tommysl8/PixelClock/case/images/foot_inside.png

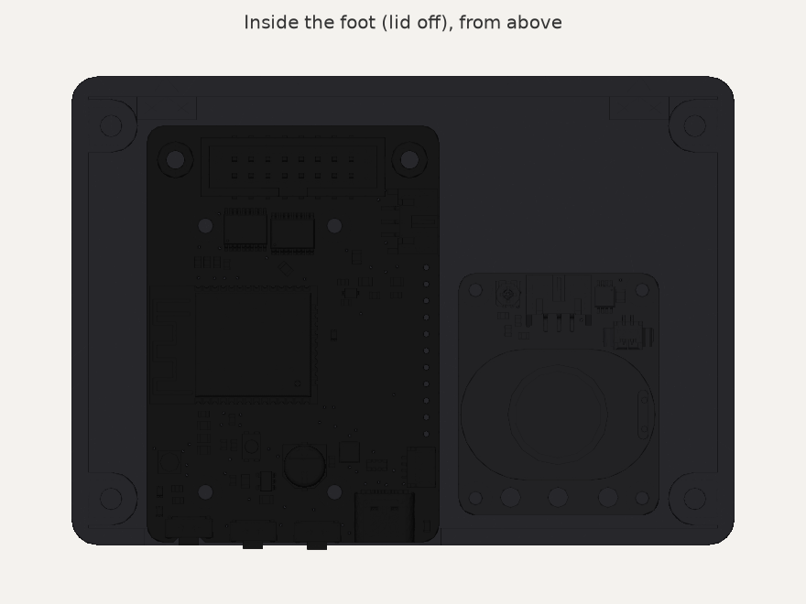
case/images/foot_inside.png
