tommysl8/PixelClock/case/images/side.png

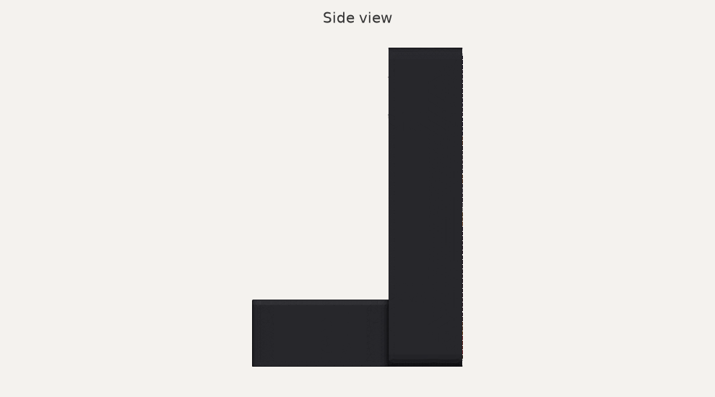
case/images/side.png
