tommysl8/PixelClock/case/step/pixelclock_case_assembly.step

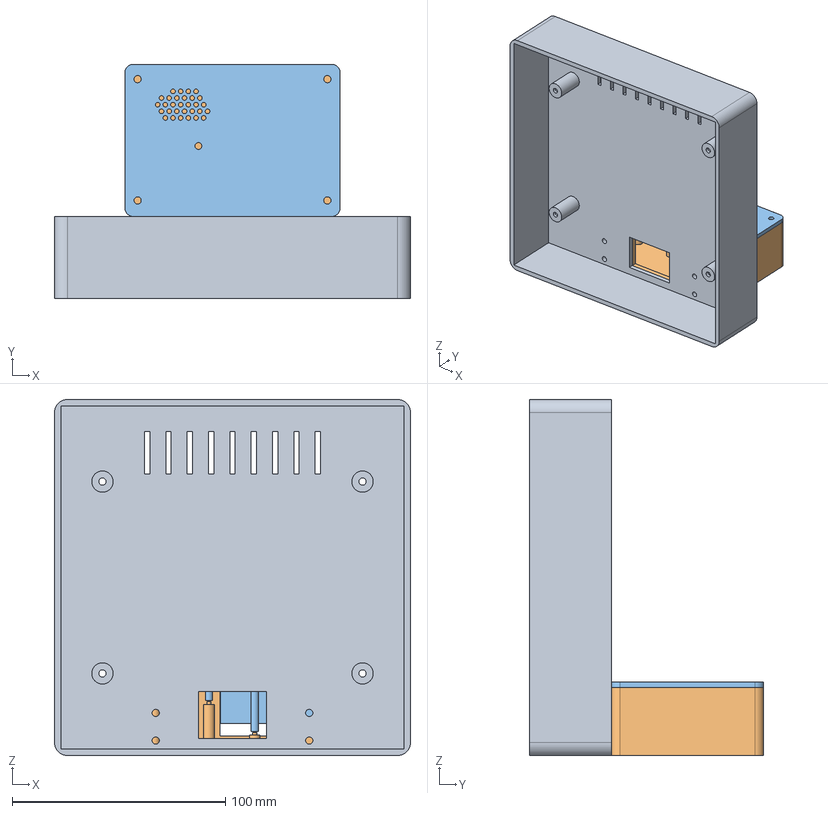
[picture p6: CAD file, 2026-11-12]
case/step/pixelclock_case_assembly.step
167.0 x 110.0 x 167.0 mm
