tommysl8/PixelClock/case/step/pixelclock_lid.step

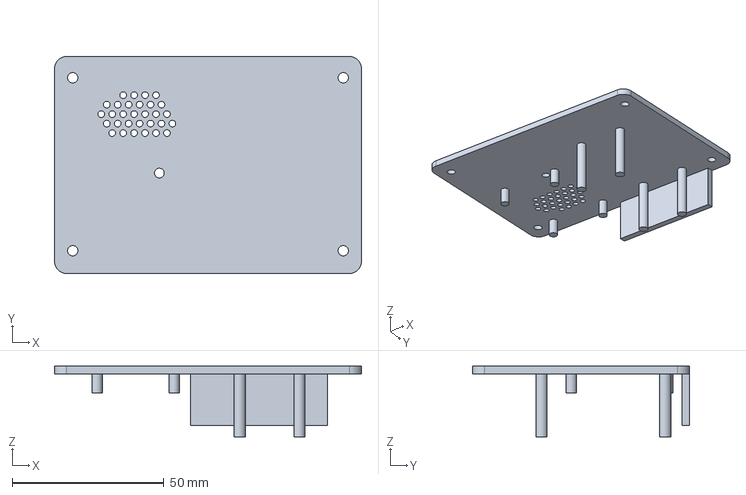
[picture p7: CAD file, 2026-11-12]
case/step/pixelclock_lid.step
101.0 x 71.4 x 23.2 mm
