tommysl8/PixelClock/case/step/pixelclock_display_no_acrylic.step

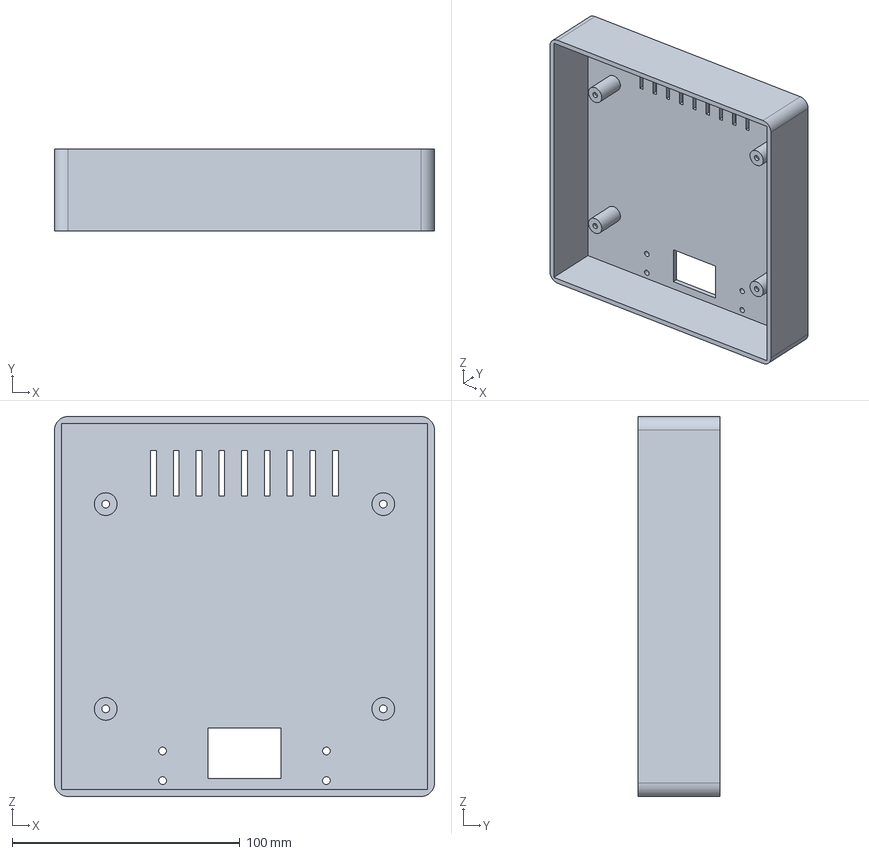
[picture p8: CAD file, 2026-11-12]
case/step/pixelclock_display_no_acrylic.step
167.0 x 36.0 x 167.0 mm
