tommysl8/PixelClock/case/step/pixelclock_display.step

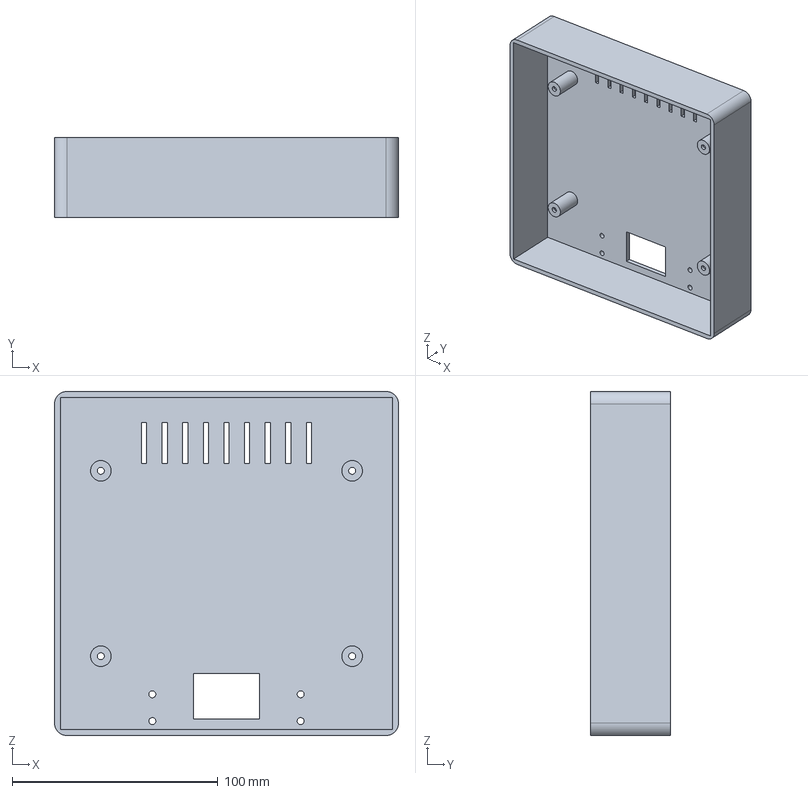
[picture p9: CAD file, 2026-11-12]
case/step/pixelclock_display.step
167.0 x 38.6 x 167.0 mm
