tommysl8/PixelClock/case/step/pixelclock_foot.step

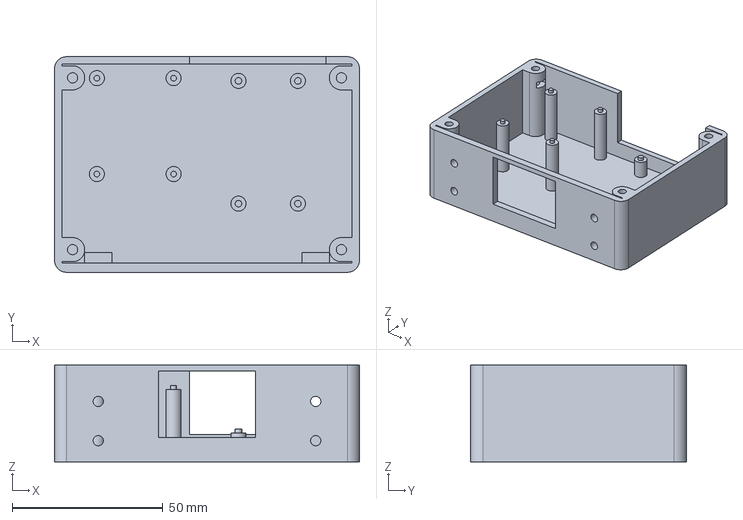
[picture p10: CAD file, 2026-11-12]
case/step/pixelclock_foot.step
101.0 x 71.4 x 32.0 mm
