tommysl8/PixelClock/(list of files, cad)

Other CAD files:
case/stl/pixelclock_display.stl
case/stl/pixelclock_display_no_acrylic.stl
case/stl/pixelclock_foot.stl
case/stl/pixelclock_lid.stl
