tommysl8/PixelClock/(commit log)

2026-11-11 Add browser simulator and winter cabin theme
    A 64x64 LED simulator for the PixelClock desk clock, with a winter cabin
    theme: animated fireplace with room glow, twinkling tree, snow past a
    window whose sky follows the time of day, a sleeping cat, and a snow
    globe effect on shake. The engine uses integer colours and a
    deterministic RNG so themes port directly to the ESP32-S3 firmware.
    Also adds a README with the parts list, wiring steps and roadmap.
2026-11-11 Add season and holiday themes with auto-switching by date
    Adds a theme for each season (Snowy hills, Spring meadow, Summer beach,
    Autumn forest) and for nine holidays (New Year's Eve, Lunar New Year,
    Valentine's Day, St. Patrick's Day, Easter, Fourth of July, Halloween,
    Thanksgiving, Christmas). The original winter cabin becomes the
    Christmas theme. Each theme has its own shake effect.
    - schedule.js picks a holiday theme in the days around each holiday and
    the season's theme otherwise (Easter and Thanksgiving are computed;
    Lunar New Year uses a 2025-2035 table)
    - engine.js gains shared sky, stars, fireworks and noise helpers, and
    the clock now has a dark outline so it reads on bright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
2026-11-11 Fix theme getting stuck when changing the date
    Picking a theme from the dropdown turned auto mode off, so changing the
    date afterwards did nothing and the clock looked stuck. Changing the
    date or pressing Today now switches back to Auto, and the label under
    the dropdown says when auto is off.
    Also hardens the simulator: the animation loop and control handlers
    catch errors and show them on the page instead of freezing, and the
    Pages deploy stamps script and stylesheet URLs with the commit so
    browsers can't mix cached files from an older deploy.
2026-11-11 Add ESP32-S3 firmware with all themes ported to C++
    The clock firmware for the Adafruit Matrix Portal S3 and a 64x64 panel:
    - lib/PixelClock: C++ port of engine.js, schedule.js and all 13 themes.
    It mirrors JavaScript semantics (rounding, xorshift RNG, order of
    random draws) so the same theme gives the same pixels; it uses double
    on the PC and float on the ESP32
    - src/main.cpp: Protomatter panel output with gamma, brightness levels,
    night dimming and a power limit for a 5V 4A supply; WiFiManager setup
    portal with a time zone field; NTP time; up/down buttons for themes and
    brightness; LIS3DH shake detection
    - tools/compare.js: compiles the C++ to WebAssembly with Zig and checks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
2026-11-11 Update parts list to verified, in-stock Adafruit parts
    The 2mm 64x64 panel is out of stock at Adafruit, so the parts list now
    uses the 2.5mm 45-degree curb-cut 64x64 panel (PID 5407, 160 mm), which
    works with the same firmware. It also links the Matrix Portal S3 (5778),
    the official Raspberry Pi 5.1V 3A USB-C supply (4298), the bent-wire
    stand (1679), a USB-A to C data cable (4474) and the optional diffusion
    acrylic (4594), with prices and stock as checked in November 2026.
    Corrects the power supply from "5V 4A USB-C" (USB-C tops out at 3A at
    5V) to 5.1V 3A, explains why the firmware's 40% power limit keeps the
    clock well under that, and spells out that the address E jumper goes to
    the pad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
    [main.cpp]
2026-11-12 Add 3D-printable case, fit-checked against Adafruit's models
    A three-part case (display frame, foot, lid) for the 64x64 2.5 mm
    curb-cut panel, Matrix Portal S3 and STEMMA Speaker. The panel sits
    flush in a 3.5 mm border; the board and speaker live in a foot behind
    it, with the USB-C port and buttons at the back so one cable leaves
    the clock. No supports needed.
    - case/pixelclock_case.py generates the parts (gmsh/OpenCASCADE) and
    writes STEP and print-oriented STL files
    - case/check_fit.py places Adafruit's own 3D models of the panel,
    board and speaker in the case and checks for collisions, hardware
    fit (nuts, screws, driver access) and room for every cable plug,
    with a self-test tha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
    [pixelclock_case_assembly.step, pixelclock_display.step, pixelclock_display.stl, pixelclock_foot.step, pixelclock_foot.stl, pixelclock_lid.step, pixelclock_lid.stl]
2026-11-12 Fit the diffusion acrylic flush in front of the panel
    The display part now holds Adafruit's 2.6 mm black LED diffusion
    acrylic (PID 4594), cut to 160 x 160 mm, in front of the LEDs with its
    face flush with the frame. The panel and everything behind it move back
    2.6 mm; the foot and lid are unchanged.
    pixelclock_display_no_acrylic.stl keeps the previous LED-flush display
    for building without the acrylic. check_fit.py checks both builds
    (--no-acrylic for the second), including the acrylic sheet itself, and
    the guide covers cutting the acrylic and taping it to the LED face.
    [pixelclock_case_assembly.step, pixelclock_display.step, pixelclock_display.stl, pixelclock_display_no_acrylic.step, pixelclock_display_no_acrylic.stl, pixelclock_foot.step, pixelclock_foot.stl, pixelclock_lid.step]
2026-11-13 Fit the simulator on one screen: clock left, controls right
    The clock now sits on the left, sized from the window height, with the
    controls in a 320 px panel on the right, grouped into Theme, Date, Time
    and Brightness. On desktop the page never scrolls; very short windows
    tighten the panel, and phones stack the clock above the controls.
    The canvas is drawn at the exact on-screen resolution so the LED grid
    stays even at any size, and the diffuser blur scales with the LED size.
